yoda-jm/body808/hardware/shield/images/shield-bottom.png

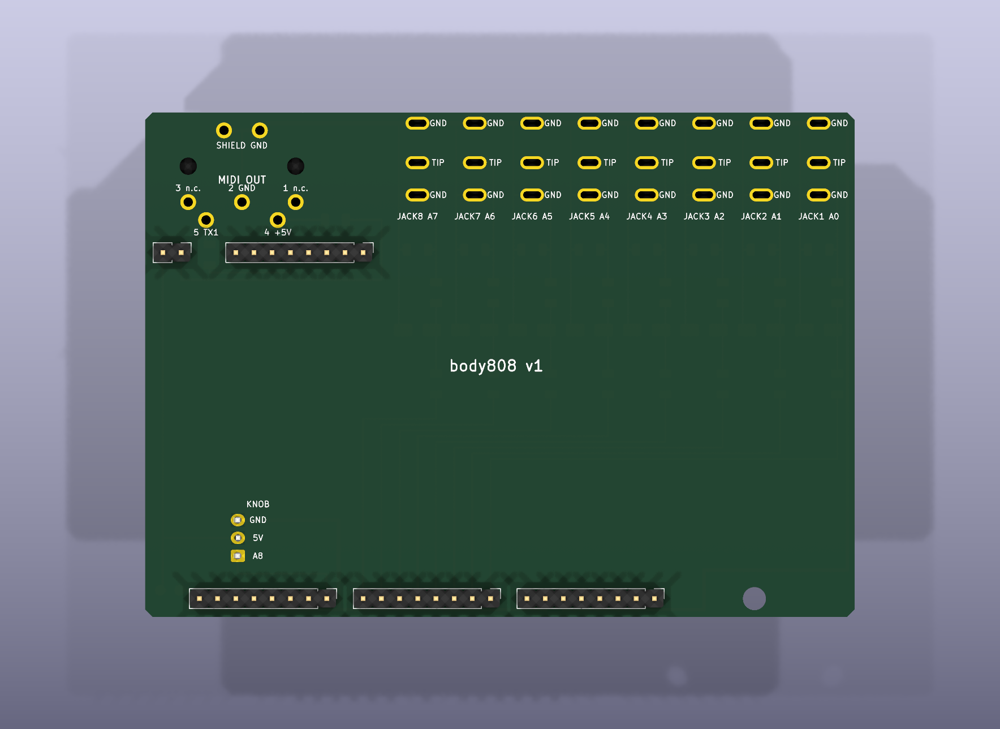
hardware/shield/images/shield-bottom.png
