yoda-jm/body808/hardware/shield/images/shield-top.png

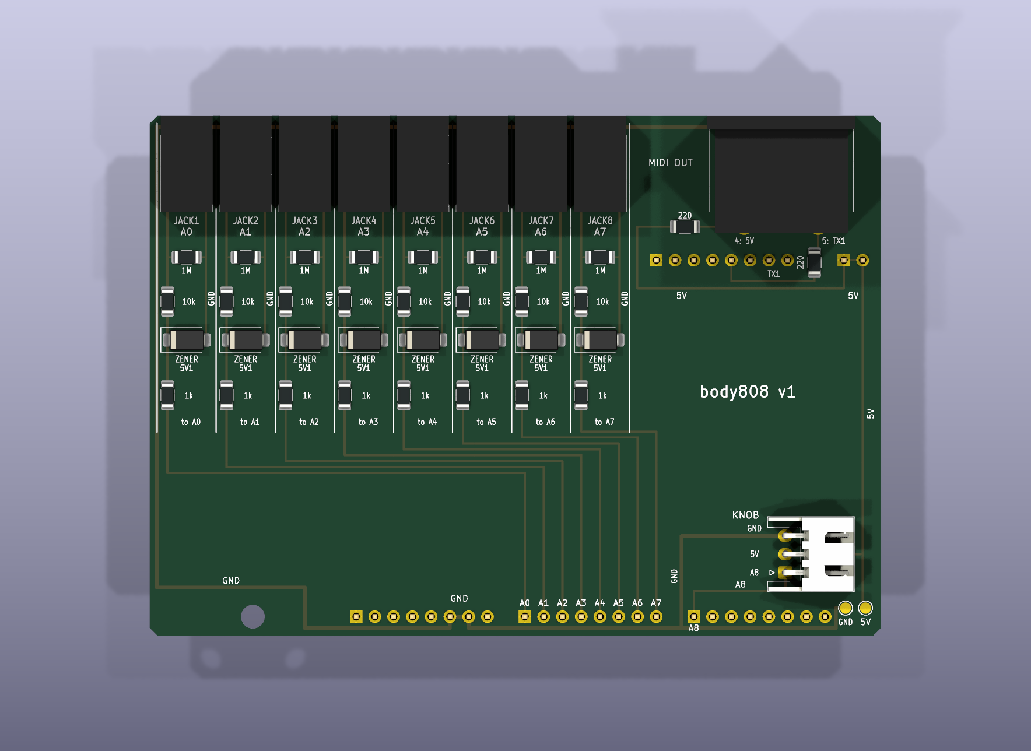
hardware/shield/images/shield-top.png
