yoda-jm/body808/docs/parts.md

# Parts list

Everything needed for 6 pads, the protection board and the MIDI OUT. Links are
**amazon.fr searches** (not specific listings, which change all the time): pick a
seller from the results and check the specs given in the "What to check" column.

✅ = already bought.

## Electronics

| Part | Qty | What to check | Link |
|---|-----|---|---|
| ✅ Arduino Mega 2560 | 1 | | |
| ✅ Piezo discs 27 mm with leads (Timesetl) | 6 + spares | 27 mm brass, leads pre-soldered | [search](https://www.amazon.fr/s?k=piezo+disque+27mm+fils) |
| ✅ Zener diodes BZX55C5V1 (5.1 V, 0.5 W) | 6 + spares | marked `5V1` / `C5V1` | [search](https://www.amazon.fr/s?k=diode+zener+BZX55C5V1) |
| ✅ Zener assortment (30 values) | | contains `4V7`, `5V1` as alternatives | |
| ✅ CME WIDI Master | 1 | | [search](https://www.amazon.fr/s?k=CME+WIDI+Master) |
| Resistor assortment, ¼ W metal film | 1 kit | must include **1 kΩ, 10 kΩ, 1 MΩ, 220 Ω** | [search](https://www.amazon.fr/s?k=kit+assortiment+resistances+1%2F4W+film+metallique) |
| Mega prototype shield, or perfboard | 1 | a Mega proto shield plugs on top of the board, no loose wires | [proto shield](https://www.amazon.fr/s?k=arduino+mega+proto+shield) · [perfboard](https://www.amazon.fr/s?k=plaque+pastilles+prototypage+pcb) |
| Male pin headers | 1 strip | 2.54 mm, to plug wires into the Mega | [search](https://www.amazon.fr/s?k=barrette+connecteur+male+2.54mm) |
| 3.5 mm **mono** jack sockets, panel mount | 6 | metal body with a nut, e.g. "PJ-392"/"PJ-301M" style; stereo sockets also work | [search](https://www.amazon.fr/s?k=prise+jack+3.5mm+femelle+chassis+panneau) |
| 3.5 mm jack cables, 1.5–2 m | 3 | cheap male-male audio cables: **cut each in half → 2 pad cables with a plug already on**. Stereo is fine (use tip + sleeve). | [search](https://www.amazon.fr/s?k=cable+jack+3.5mm+male+male+2m) |
| or: shielded cable + 3.5 mm plugs | ~10 m + 6 | thin 1-core shielded "microphone" cable, metal plugs | [cable](https://www.amazon.fr/s?k=cable+micro+blinde+1+conducteur) · [plugs](https://www.amazon.fr/s?k=fiche+jack+3.5mm+male+mono+a+souder) |
| DIN-5 female socket, panel mount | 1 | 5 pins at 180° (MIDI) | [search](https://www.amazon.fr/s?k=prise+DIN+5+broches+femelle+chassis+MIDI) |
| 9 V battery clip with 5.5 × 2.1 mm barrel plug | 1 | fits the Mega's power jack | [search](https://www.amazon.fr/s?k=clip+pile+9V+jack+5.5x2.1) |
| or: small USB power bank | 1 | simpler, lasts longer than a 9 V battery | [search](https://www.amazon.fr/s?k=batterie+externe+usb+mini) |
| Potentiometer 10 kΩ linear (B10K) + knob | 1 | optional sensitivity knob; panel mount with a nut | [search](https://www.amazon.fr/s?k=potentiometre+B10K+lineaire+bouton) |
| Hookup wire (22–24 AWG) | 1 set | for the protection board | [search](https://www.amazon.fr/s?k=fil+electrique+22awg+kit) |
| Heat-shrink tubing kit | 1 | | [search](https://www.amazon.fr/s?k=gaine+thermoretractable+kit) |
| Multimeter with diode test | 1 | to check the board before connecting it | [search](https://www.amazon.fr/s?k=multimetre+numerique+test+diode) |

## Pads

| Part | Qty | What to check | Link |
|---|-----|---|---|
| Acrylic (plexiglass) discs 50 mm, 2–3 mm thick | 6 + spares | ready-cut round discs save cutting | [search](https://www.amazon.fr/s?k=disque+plexiglass+50mm+3mm) |
| or: acrylic sheet 2–3 mm to cut | 1 | A5/A4 sheet, cut with a hole saw or a fretsaw | [search](https://www.amazon.fr/s?k=plaque+plexiglass+3mm) |
| Neoprene sheet 3–5 mm | 1 | or simply an old mouse pad | [search](https://www.amazon.fr/s?k=feuille+neoprene+3mm) |
| EVA foam sheets 2–5 mm | 1 pack | closed-cell craft foam | [search](https://www.amazon.fr/s?k=feuille+mousse+eva+5mm) |
| Thin double-sided tape | 1 | thin, **not** foam tape | [search](https://www.amazon.fr/s?k=ruban+adhesif+double+face+fin) |
| 2-part epoxy | 1 | for final assembly | [search](https://www.amazon.fr/s?k=colle+epoxy+bi+composant) |
| Hot glue gun + sticks | 1 | | [search](https://www.amazon.fr/s?k=pistolet+colle+chaude) |
| Kapton tape | 1 roll | to cover the ceramic and solder joints | [search](https://www.amazon.fr/s?k=ruban+kapton) |
| Contact glue for neoprene | 1 | to glue foam to the plate | [search](https://www.amazon.fr/s?k=colle+neoprene+contact) |

## Wearing

| Part | Qty | For | Link |
|---|-----|-----|---|
| Elastic straps with Velcro | 4–6 | ankles, legs | [search](https://www.amazon.fr/s?k=sangle+elastique+velcro+reglable) |
| Sports phone armbands | 2 | thighs (pad in the phone pocket) | [search](https://www.amazon.fr/s?k=brassard+telephone+sport) |
| Chest strap (heart-rate belt replacement) | 1 | chest pad on the sternum | [search](https://www.amazon.fr/s?k=ceinture+thoracique+cardio+sangle+remplacement) |
| Fingerless gloves | 1 pair | hand pads in the palm | [search](https://www.amazon.fr/s?k=gants+sans+doigts+fitness) |
| Belt bag | 1 | carries the Mega, the battery and the WIDI | [search](https://www.amazon.fr/s?k=sac+banane+sport) |
| Self-gripping cable ties (Velcro) | 1 pack | bundle the pad cables along the body | [search](https://www.amazon.fr/s?k=serre+cable+velcro) |
