yoda-jm/body808/hardware/shield/fab/bom-jlcpcb.csv

Comment | Designator | Footprint | LCSC Part #
10k | R102,R202,R302,R402,R502,R602,R702,R802 | R_1206_3216Metric | C17902
1M | R101,R201,R301,R401,R501,R601,R701,R801 | R_1206_3216Metric | C17927
1k | R103,R203,R303,R403,R503,R603,R703,R803 | R_1206_3216Metric | C4410
220 | R1,R2 | R_1206_3216Metric | C17957
5V1 | D101,D201,D301,D401,D501,D601,D701,D801 | D_SMA | C19077476
KNOB | J11 | JST_XH_S3B-XH-A_1x03_P2.50mm_Horizontal | C157928
PJ-316 | J21,J22,J23,J24,J25,J26,J27,J28 | PJ-316 | C5123139
SDS-50J | J10 | SDS-50J | C6216157
