yoda-jm/body808/hardware/shield/body808-shield-schematic.pdf

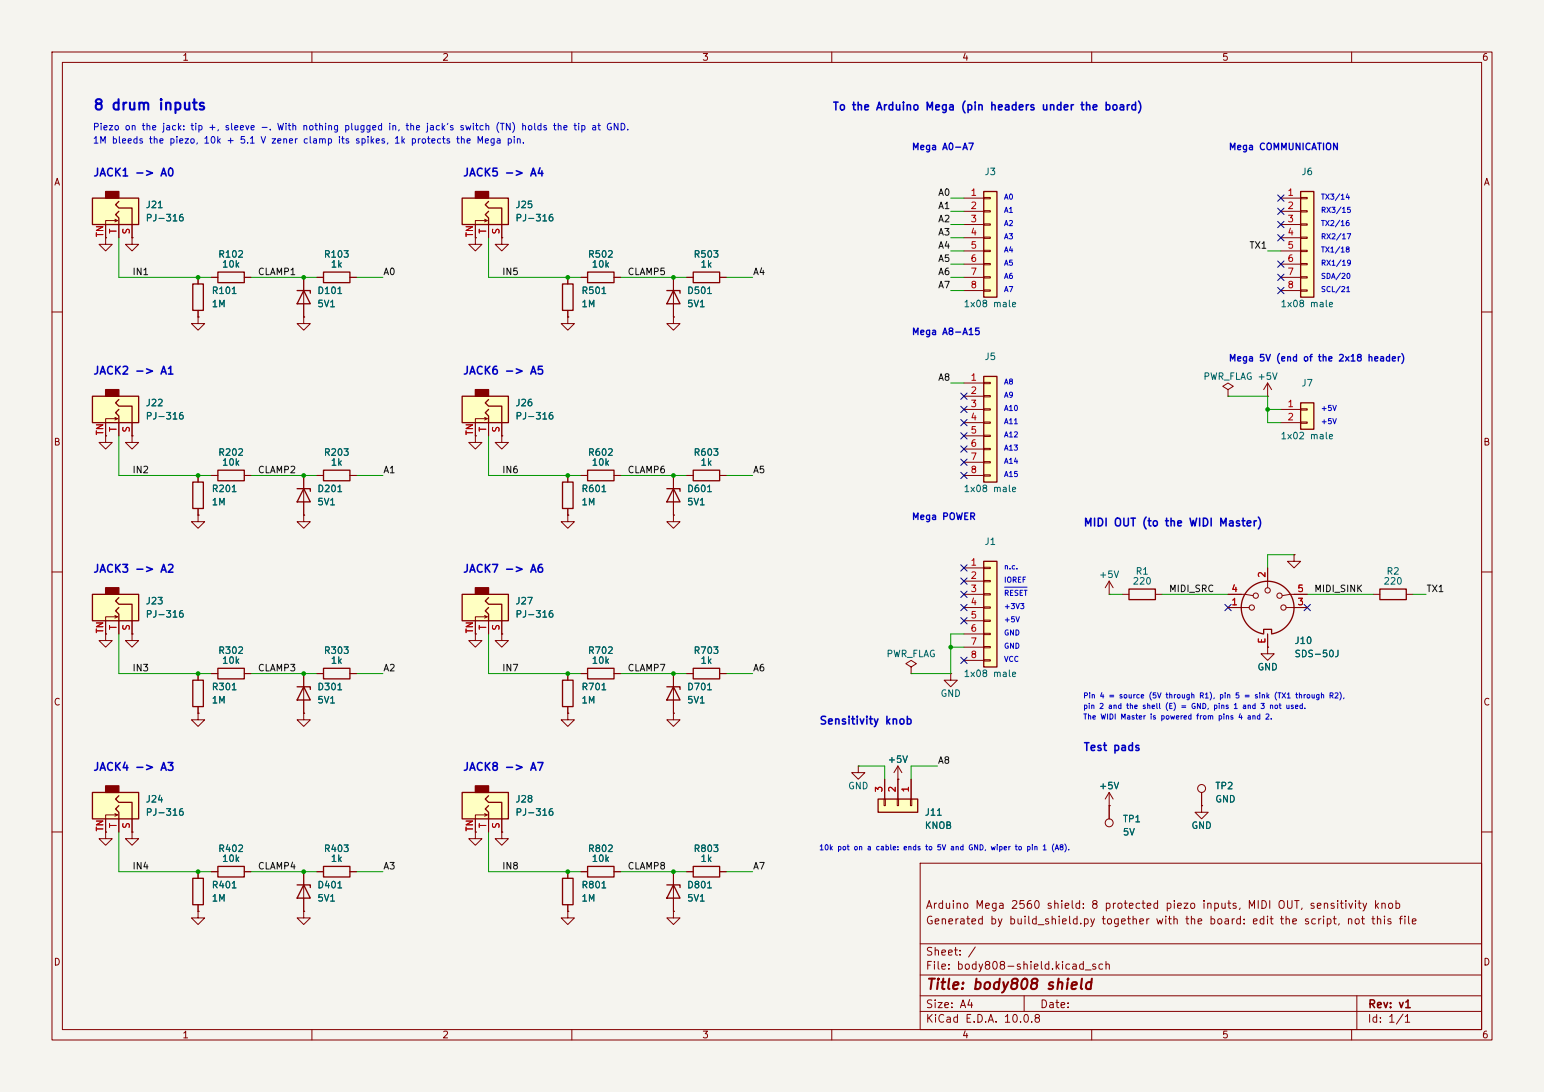
[picture p6: page 1]

A0 To the Arduino Mega (pin headers under the board)
+3V3 Mega A0-A7

1M bleeds the piezo, 10k + 5.1 V zener clamp its spikes, 1k protects the Mega pin. Piezo on the jack: tip +, sleeve -. With nothing plugged in, the jack's switch (TN) holds the tip at GND. JACK2 -> A1

Mega 5V (end of the 2x18 header) +5V +5V Pin 4 = source (5V through R1), pin 5 = sink (TX1 through R2), +5V JACK4 -> A3

pin 2 and the shell (E) = GND, pins 1 and 3 not used.
The WIDI Master is powered from pins 4 and 2.

10k pot on a cable: ends to 5V and GND, wiper to pin 1 (A8).

Arduino Mega 2560 shield: 8 protected piezo inputs, MIDI OUT, sensitivity knob
Generated by build_shield.py together with the board: edit the script, not this file

Size: A4 | Rev: v1
KiCad E.D.A. 10.0.8 | Id: 1/1
