yoda-jm/body808/hardware/shield/body808-shield.kicad_pcb

## KiCad design hardware/shield/body808-shield.kicad_pcb (2026-11-05)

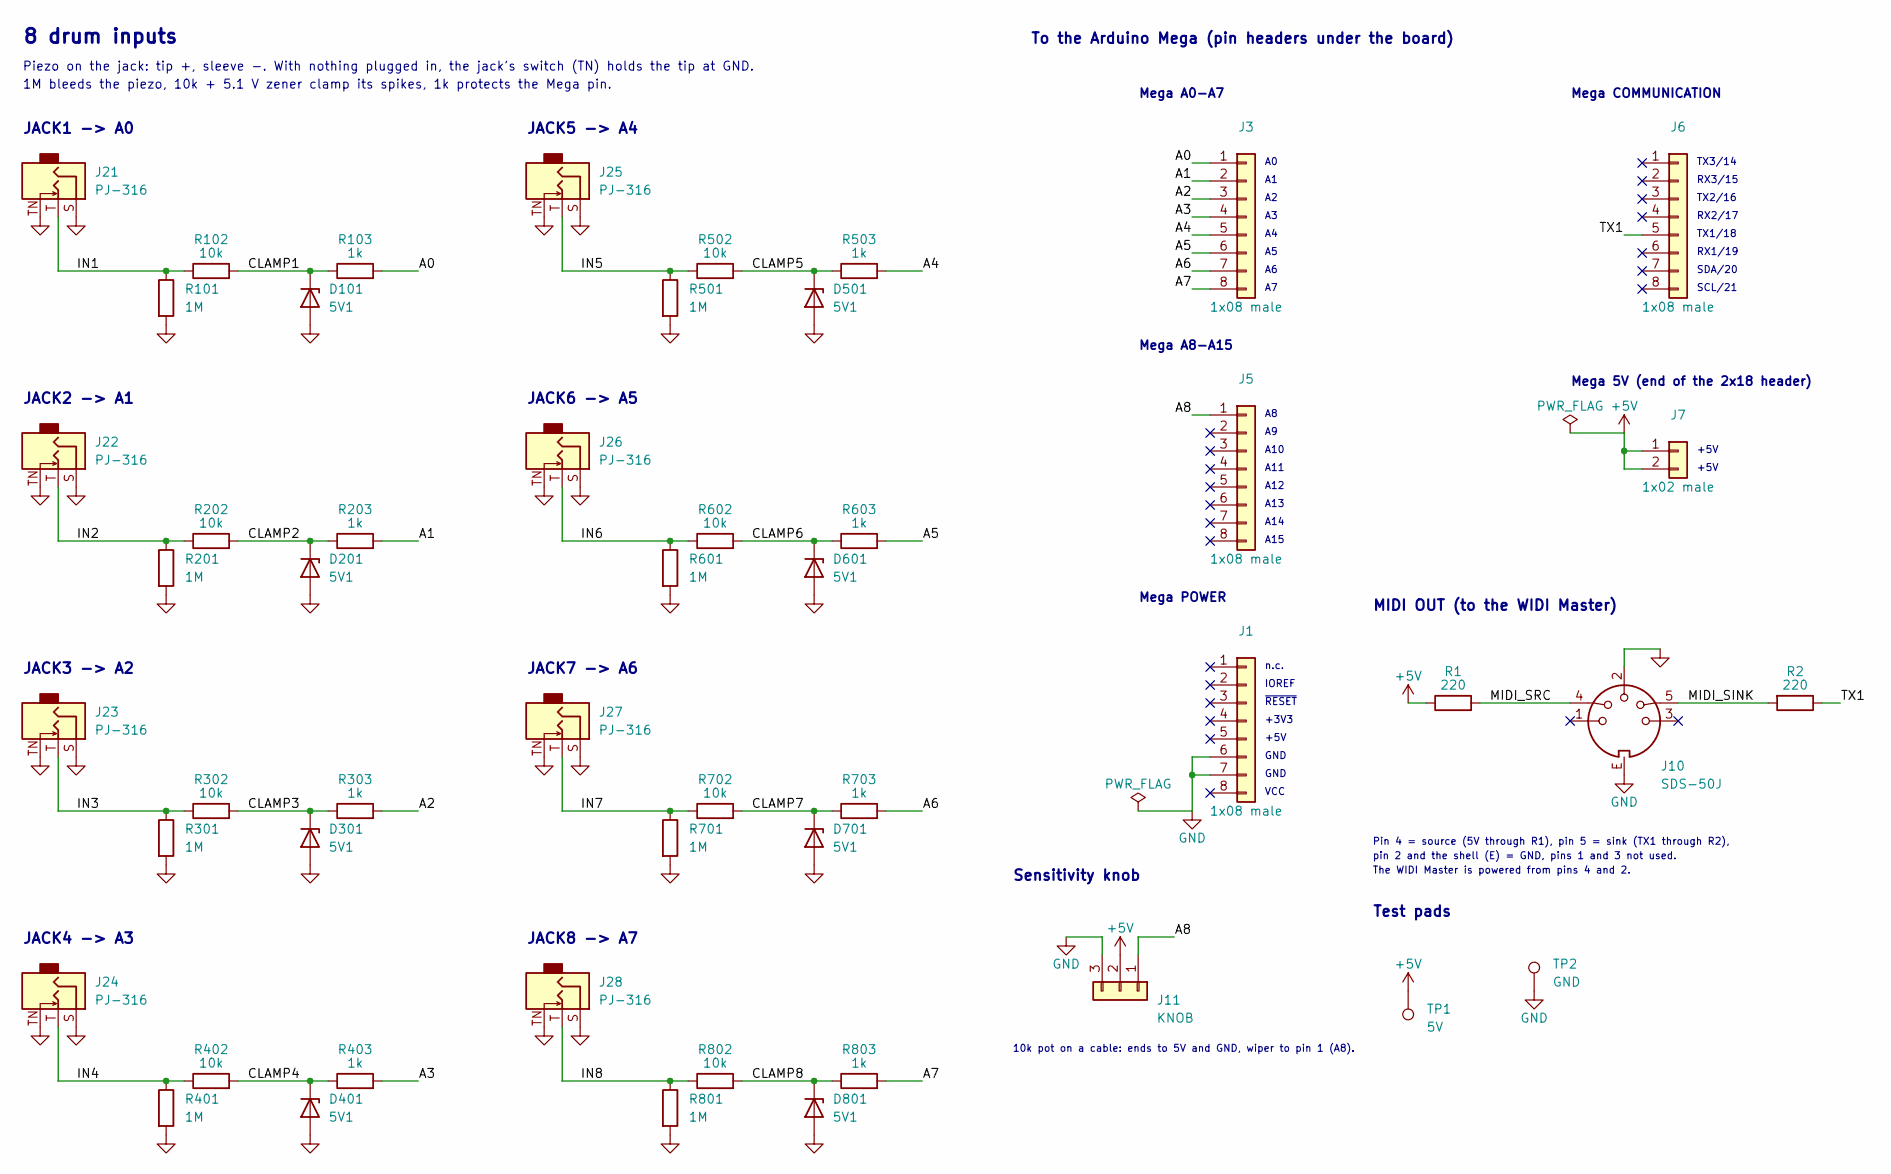
[picture p7: schematic body808-shield.kicad_sch, body808 shield]

Parts:
D101, D201, D301, D401, D501, D601, D701, D801: 5V1; D_SMA; LCSC C19077476
J1, J3, J5, J6: 1x08 male; PinHeader_1x08_P2.54mm_Vertical; LCSC C492407
J7: 1x02 male; PinHeader_1x02_P2.54mm_Vertical
J10: SDS-50J; MPN CUI SDS-50J; LCSC C6216157
J11: KNOB; JST_XH_S3B-XH-A_1x03_P2.50mm_Horizontal; LCSC C157928
J21, J22, J23, J24, J25, J26, J27, J28: PJ-316; MPN KH-PJ-316-3P (or CAX PJ-316, C50176628); LCSC C5123139
R1, R2: 220; R_1206_3216Metric; LCSC C17957
R101, R201, R301, R401, R501, R601, R701, R801: 1M; R_1206_3216Metric; LCSC C17927
R102, R202, R302, R402, R502, R602, R702, R802: 10k; R_1206_3216Metric; LCSC C17902
R103, R203, R303, R403, R503, R603, R703, R803: 1k; R_1206_3216Metric; LCSC C4410
TP1: 5V; TestPoint_Pad_D1.5mm
TP2: GND; TestPoint_Pad_D1.5mm

Connections:
+5V: J7.1, J7.2, J11.2, R1.1, TP1.1
/A0: J3.1, R103.2
/A1: J3.2, R203.2
/A2: J3.3, R303.2
/A3: J3.4, R403.2
/A4: J3.5, R503.2
/A5: J3.6, R603.2
/A6: J3.7, R703.2
/A7: J3.8, R803.2
/A8: J5.1, J11.1
/CLAMP1: D101.1 (K), R102.2, R103.1
/CLAMP2: D201.1 (K), R202.2, R203.1
/CLAMP3: D301.1 (K), R302.2, R303.1
/CLAMP4: D401.1 (K), R402.2, R403.1
/CLAMP5: D501.1 (K), R502.2, R503.1
/CLAMP6: D601.1 (K), R602.2, R603.1
/CLAMP7: D701.1 (K), R702.2, R703.1
/CLAMP8: D801.1 (K), R802.2, R803.1
/IN1: J21.T, R101.1, R102.1
/IN2: J22.T, R201.1, R202.1
/IN3: J23.T, R301.1, R302.1
/IN4: J24.T, R401.1, R402.1
/IN5: J25.T, R501.1, R502.1
/IN6: J26.T, R601.1, R602.1
/IN7: J27.T, R701.1, R702.1
/IN8: J28.T, R801.1, R802.1
/MIDI_SINK: J10.5, R2.2
/MIDI_SRC: J10.4, R1.2
/TX1: J6.5, R2.1
GND: D101.2 (A), D201.2 (A), D301.2 (A), D401.2 (A), D501.2 (A), D601.2 (A), D701.2 (A), D801.2 (A), J1.6, J1.7, J10.2, J10.E, J11.3, J21.S, J21.TN, J22.S, J22.TN, J23.S, J23.TN, J24.S, J24.TN, J25.S, J25.TN, J26.S, J26.TN, J27.S, J27.TN, J28.S, J28.TN, R101.2, R201.2, R301.2, R401.2, R501.2, R601.2, R701.2, R801.2, TP2.1

Notes on the sheet:
The WIDI Master is powered from pins 4 and 2.
IOREF
A13
GND
10k pot on a cable: ends to 5V and GND, wiper to pin 1 (A8).
Mega 5V (end of the 2x18 header)
Mega A0-A7
Sensitivity knob
MIDI OUT (to the WIDI Master)
A14
TX3/14
1M bleeds the piezo, 10k + 5.1 V zener clamp its spikes, 1k protects the Mega pin.
Pin 4 = source (5V through R1), pin 5 = sink (TX1 through R2),
JACK6 -> A5
Mega A8-A15
JACK5 -> A4
JACK2 -> A1
SCL/21
n.c.
Mega COMMUNICATION
JACK3 -> A2
~{RESET}
8 drum inputs
+5V
RX3/15
JACK1 -> A0
To the Arduino Mega (pin headers under the board)
A12
pin 2 and the shell (E) = GND, pins 1 and 3 not used.
TX1/18
VCC
A11
Piezo on the jack: tip +, sleeve -. With nothing plugged in, the jack's switch (TN) holds the tip at GND.
A15
+3V3
SDA/20
RX2/17
JACK7 -> A6
Test pads
TX2/16
Mega POWER
JACK4 -> A3
RX1/19
JACK8 -> A7
A10

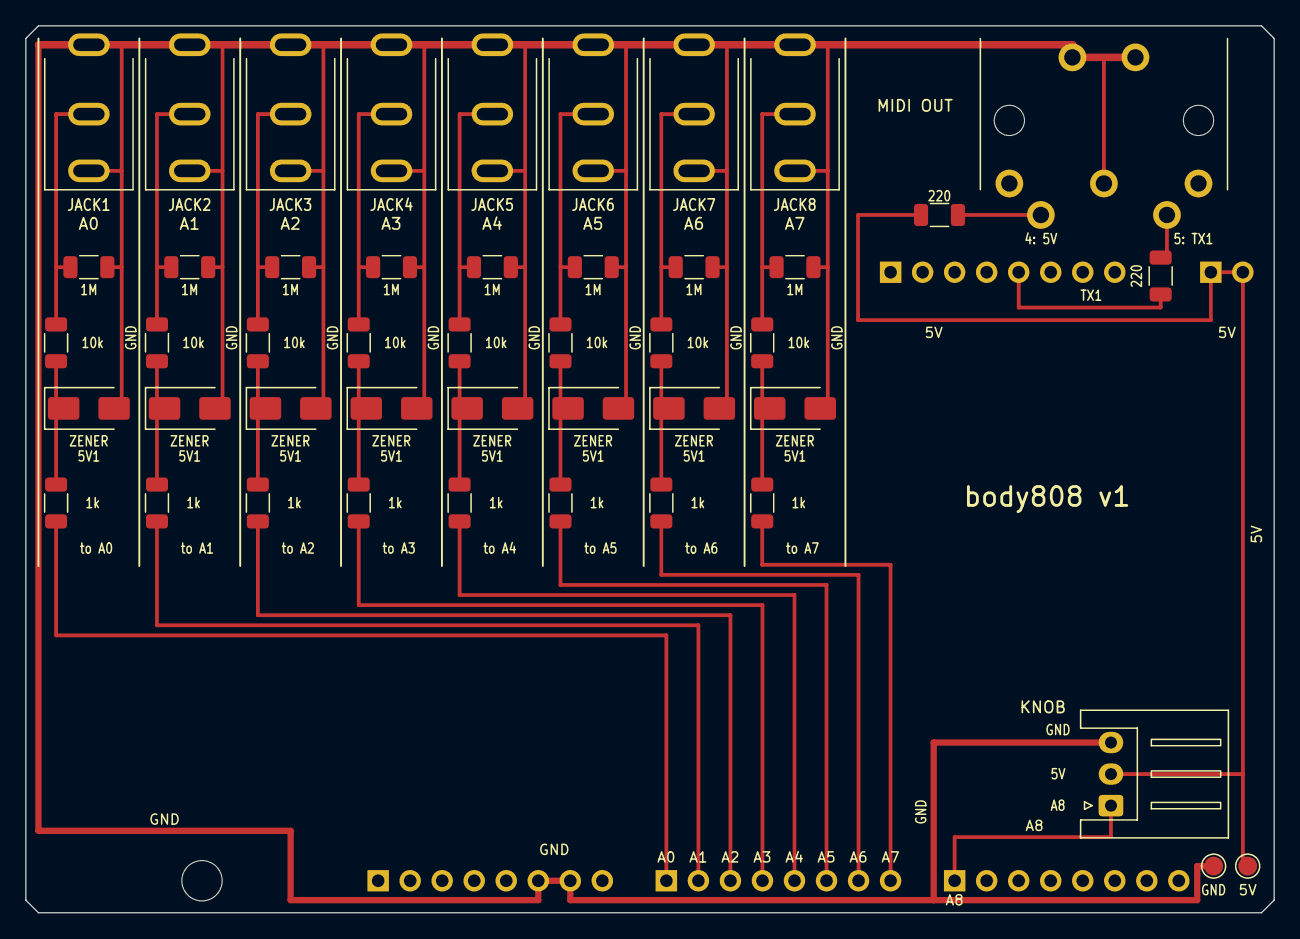
[picture p8: board body808-shield.kicad_pcb from above]

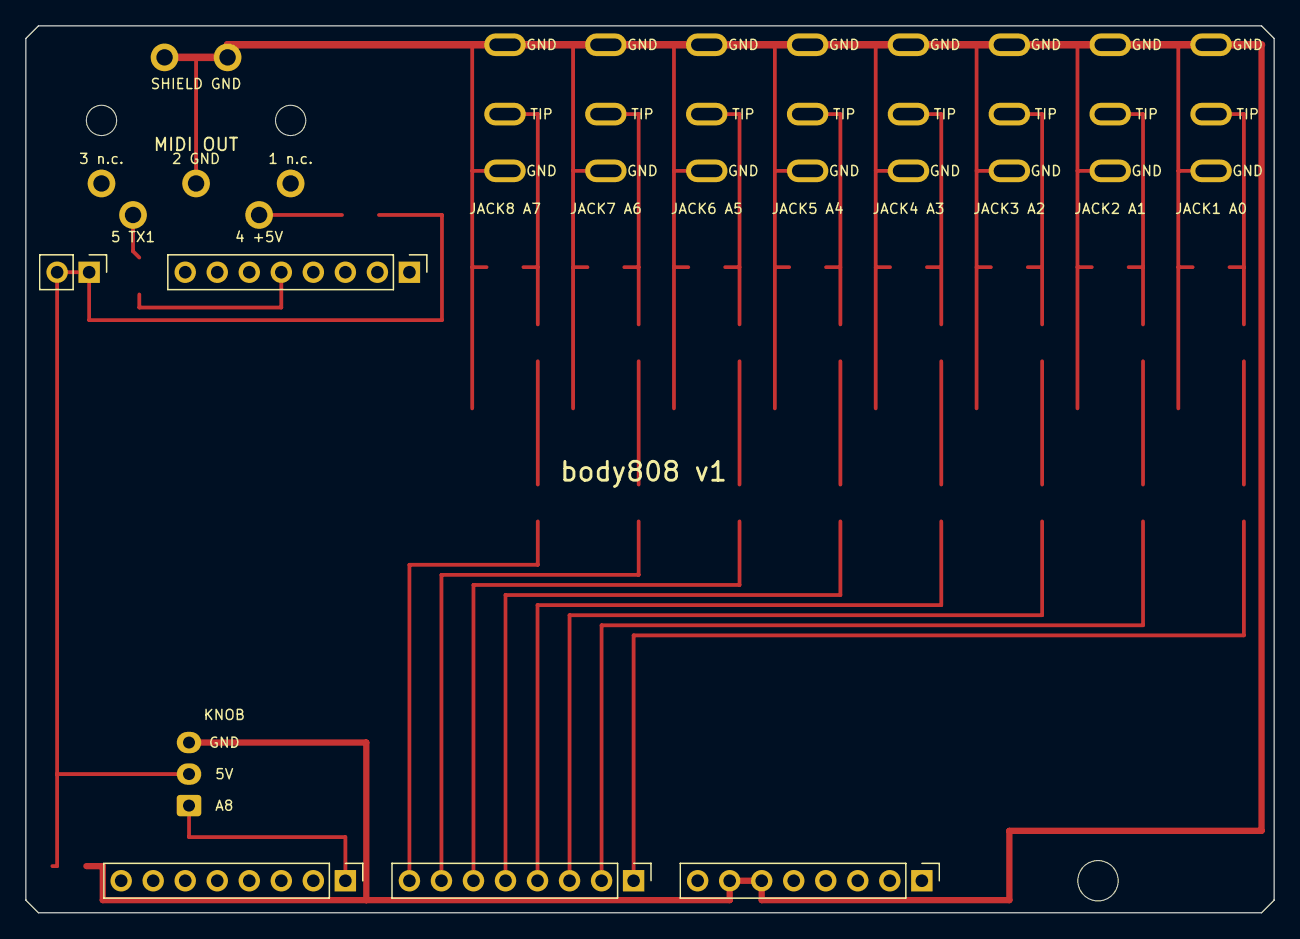
[picture p9: board body808-shield.kicad_pcb from below]

Board: 2 copper layers, 99.0 x 70.3 mm, 52 parts (5 on the bottom side), 30 nets.

Other parts of the board:
MH2: M3; MountingHole_3.2mm_M3
