yoda-jm/body808/(commit log)

2026-10-07 Body percussion: piezo pads to MIDI drum notes
    Arduino Mega firmware that detects hits on 6 piezo pads and sends GM drum
    notes (display, MIDI on TX1, or raw MIDI over USB serial), a serial-to-ALSA
    MIDI bridge, a Hydrogen drumkit generator for beatbox samples, and docs with
    the input protection schematics.
2026-10-07 Document the CME WIDI Master radio link
    MIDI OUT wiring that also powers the adapter, LED meanings, pairing with
    Linux through BlueZ (Gentoo midi USE flag) or a CME USB receiver.
2026-10-07 Protection: use 5.1 V zener + 1k pin resistor
    The zener (BZX55C5V1) needs no +5V rail. Its ~-0.7 V forward drop on
    negative spikes is past the pin's -0.5 V limit, so a 1 kOhm resistor
    keeps the current into the chip's own clamp diodes under ~0.5 mA. The
    Schottky pair stays documented as an alternative.
2026-10-07 Docs: pad construction for 27 mm piezo discs
    Materials table (plate, foam, glue, insulation, straps), wiring on the
    pad, and placement per body part. Feet pads go on the outside of the
    shoe, not in the insole, so the ceramic never carries body weight.
2026-10-07 Docs: pad mounting diagram, parts list, cable signal loss
    Pad cross-section and wiring diagram, a parts list with amazon.fr search
    links, why cable length doesn't attenuate the piezo signal (and what
    does matter), and explicit zener labels on the overview schematic.
2026-10-07 Optional global sensitivity knob on A6
    A 10 kOhm pot scales every pad's threshold and maxLevel between x2
    (less sensitive) and x0.5 (more sensitive), read every 20 ms with a
    small dead band. Off by default: an unconnected pin reads noise.
    [body808.ino]
2026-10-07 Simulate the protection board and hit detection in ngspice
    sim/: piezo disc (Butterworth-Van Dyke, Timesetl values), 1N4733A and
    BZX55C5V1 zener models fitted to their datasheets, ATmega2560 pin model,
    sweeps of hit strength, shape and part tolerances, and a replay of the
    firmware's hit detector on the simulated pin voltage.
    docs/simulation.md: seven board configurations (as built, BZX55, 100/200 nF
    across the disc, 100 nF with smoothing, R1 as trimmer) with schematics,
    waveforms, detection tests, and pros and cons of each.
2026-10-08 Tune the retrigger settings by simulation: ratio 0.25, decay 50 ms
    sim/tuning.py replays simulated single hits and soft-after-loud pairs
    through the firmware for every RETRIGGER_RATIO / DECAY_US / MASK_US
    combination on three boards (as built, 100 nF, 200 nF). 0.25 and 50 ms
    give no double notes anywhere and stop swallowing a soft hit right after
    a loud one (as built: 5 of 30 pairs missed -> 0). Lower values let the
    zener's tail play ghost notes as built.
    docs/simulation.md gets a tuning section and is redrawn with the new
    values; the main README gets a Simulation section.
    [body808.ino]
2026-11-05 Ignore bench photos, KiCad scratch files and local history
    photos/ holds the full-size tablet photos of the build (kept for the
    website, too big for the repo). KiCad writes per-user state (.kicad_prl),
    lock files, autosaves and its Local History snapshots (.history/) next to
    the project; none of it belongs in git.
2026-11-05 Shield PCB for the Mega: KiCad board, schematic and JLCPCB files
    A board that stacks on the Arduino Mega 2560 and replaces the
    breadboard: 8 protected inputs on side-entry 3.5 mm jacks (A0-A7), a
    MIDI OUT DIN socket for the WIDI Master, and a JST connector for the
    sensitivity knob (A8). All copper is on the top layer, laid out lane by
    lane like the schematic. ERC, DRC and schematic parity are clean.
    build_shield.py builds the board, then the schematic (schematic.py) from
    the board's own nets; symbols and footprints share UUIDs, so KiCad
    checks that the two agree. make_fab.sh runs the checks and writes the
    JLCPCB upload (fab/: Gerber zip, BOM, placement), the schematic PDF and
    the pictures.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
2026-11-05 Firmware: bench-test settings (only A0 wired, MIDI over USB serial)
    The breadboard test has a single input on A0, so the other pads are
    commented out (floating inputs would play ghost notes) and MIDI goes to
    the PC over USB for tools/serial_midi_bridge.py. Restore pads A1-A5 and
    the MIDI mode before using more than one pad.
2026-11-05 Shield: side view of how it stacks on the Mega
    A to-scale drawing (stacking.py) of the shield on the Mega, seen from
    the USB end: today's pin headers under the board, and stackable headers
    on top as the alternative that would keep assembly one-sided (not in
    stock at JLCPCB when checked).
